denisgav/stm32f401ccu6_uac2_headset/easyeda/Schematic_stm32f401ccu6_uac2_hid_headset_redesign_v2_2024-11-17.pdf

3V3 20 VB 40 C13 39 C14 38 C15 37 Reset 36 A0 35 A1 34 A2 33 A3 32 A4 31 A5 30 A6 29 A7 28 B0 27 B1 26 B2 25 B10 24 3V3 23 GND 22 5V 21 3V3 41 DIO 42 SCK 43 GND 44

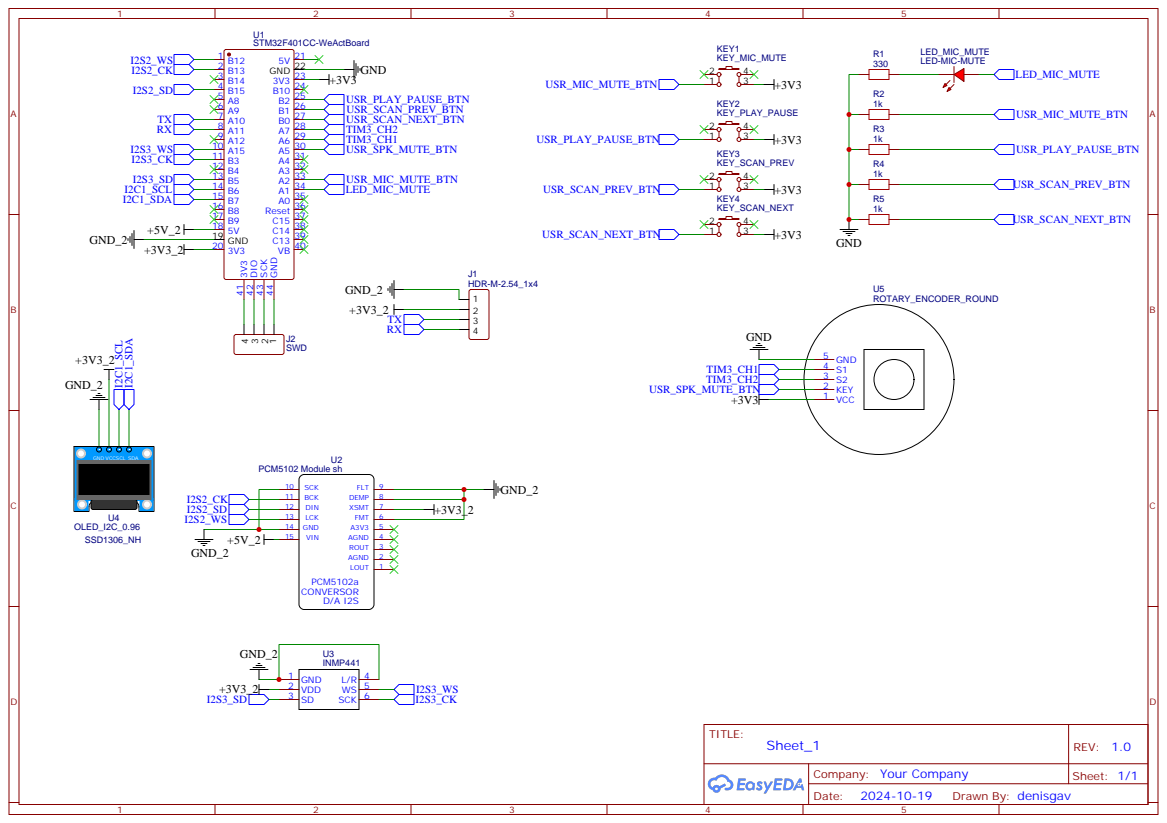
[picture p1: page 1]
