denisgav/stm32f401ccu6_uac2_headset/easyeda/Schematic_ESP32_C3_BT_mouse_drigatel_2024-11-17.pdf

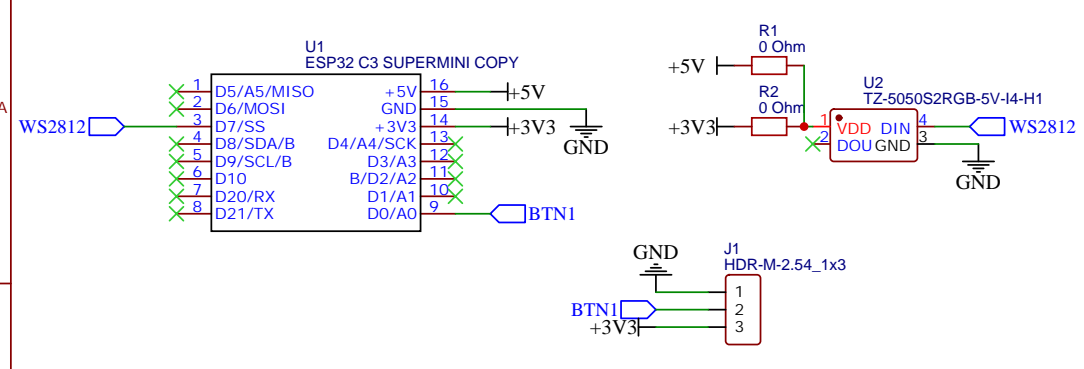
[picture p2: page 1]
