denisgav/stm32f401ccu6_uac2_headset/Core/Src/main.c

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
/* Includes ------------------------------------------------------------------*/
#include "main.h"

/* USER CODE BEGIN Includes */
#include <stdio.h>
#include <string.h>

#include "bsp/board_api.h"
#include "tusb.h"
#include "usb_descriptors.h"

#include "usb_headset.h"
#include "volume_ctrl.h"
#include "ring_buf.h"
#include "usb_headset_settings.h"

#include "ssd1306.h"
#include "ssd1306_fonts.h"

#include "usb_hid_status.h"
/* USER CODE END Includes */

I2C_HandleTypeDef hi2c1;
DMA_HandleTypeDef hdma_i2c1_tx;

I2S_HandleTypeDef hi2s2;
I2S_HandleTypeDef hi2s3;
DMA_HandleTypeDef hdma_spi2_tx;
DMA_HandleTypeDef hdma_spi3_rx;

TIM_HandleTypeDef htim3;

PCD_HandleTypeDef hpcd_USB_OTG_FS;

/* USER CODE BEGIN PV */
usb_headset_settings_t current_settings;

// Buffer for speaker data
ring_buf_t spk_ring_buffer;
uint32_t *spk_ring_buffer_storage;

// Buffer for microphone data
ring_buf_t mic_ring_buffer;
uint32_t *mic_ring_buffer_storage;

// Buffer for speaker data
uint8_t spk_usb_read_buf[SAMPLE_BUFFER_SIZE * 2 * 4 * 2]; // Max size of audio sample is  2 * 4. 2 Channels, 4 byte width sample
i2s_32b_audio_sample spk_32b_i2s_buffer[SAMPLE_BUFFER_SIZE];
i2s_16b_audio_sample spk_16b_i2s_buffer[SAMPLE_BUFFER_SIZE];
uint32_t spk_i2s_buf[SAMPLE_BUFFER_SIZE * 2];

// Buffer for microphone data
uint32_t mic_usb_24b_buffer[SAMPLE_BUFFER_SIZE];
uint16_t mic_usb_16b_buffer[SAMPLE_BUFFER_SIZE];
uint32_t mic_i2s_buf[SAMPLE_BUFFER_SIZE * 2];
uint32_t mic_i2s_read_buffer[SAMPLE_BUFFER_SIZE];
uint32_t num_of_mic_samples;

uint32_t get_num_of_mic_samples();

usb_hid_status_t hid_status;
void check_buttons(void);
void usb_hid_task(void);

void led_blinking_task(void);

HAL_StatusTypeDef refresh_i2s_spk(void);
HAL_StatusTypeDef refresh_i2s_mic(void);
HAL_StatusTypeDef refresh_clk(void);
void refresh_i2s_connections(void);

int32_t usb_to_i2s_32b_sample_convert(int32_t sample, uint32_t volume_db);
int16_t usb_to_i2s_16b_sample_convert(int16_t sample, uint32_t volume_db);

void usb_headset_mute_handler(int8_t bChannelNumber, int8_t mute_in);
void usb_headset_volume_handler(int8_t bChannelNumber, int16_t volume_in);
void usb_headset_current_sample_rate_handler(uint32_t current_sample_rate_in);
void usb_headset_current_resolution_handler(uint8_t itf,
		uint8_t current_resolution_in);
void usb_headset_current_status_set_handler(uint8_t itf,
		uint32_t blink_interval_ms_in);

void usb_headset_tud_audio_rx_done_pre_read_handler(uint8_t rhport,
		uint16_t n_bytes_received, uint8_t func_id, uint8_t ep_out,
		uint8_t cur_alt_setting);
void usb_headset_tud_audio_tx_done_pre_load_handler(uint8_t rhport, uint8_t itf,
		uint8_t ep_in, uint8_t cur_alt_setting);
void usb_headset_tud_audio_tx_done_post_load_handler(uint8_t rhport,
		uint16_t n_bytes_copied, uint8_t itf, uint8_t ep_in,
		uint8_t cur_alt_setting);

int spk_machine_i2s_write_stream(uint32_t *buf_in, uint32_t size);
int mic_machine_i2s_read_stream(uint32_t *buf_in, uint32_t size);

void HAL_I2S_TxHalfCpltCallback(I2S_HandleTypeDef *hi2s);
void HAL_I2S_TxCpltCallback(I2S_HandleTypeDef *hi2s);
void HAL_I2S_RxHalfCpltCallback(I2S_HandleTypeDef *hi2s);
void HAL_I2S_RxCpltCallback(I2S_HandleTypeDef *hi2s);
//void HAL_I2S_ErrorCallback(I2S_HandleTypeDef *hi2s);
void HAL_GPIO_EXTI_Callback(uint16_t GPIO_Pin);

uint32_t feed_spk_dma(uint32_t *dma_buffer_p,
		uint32_t sizeof_half_dma_buffer_in_bytes);

uint32_t empty_mic_dma(uint32_t *dma_buffer_p,
		uint32_t sizeof_half_dma_buffer_in_words);

void status_update_task(void);
void display_ssd1306_info(void);

/* USER CODE END PV */

void SystemClock_Config(void);
void PeriphCommonClock_Config(void);
static void MX_GPIO_Init(void);
static void MX_DMA_Init(void);
static void MX_TIM3_Init(void);
static void MX_I2C1_Init(void);
static void MX_I2S2_Init(void);
static void MX_I2S3_Init(void);
static void MX_USB_OTG_FS_PCD_Init(void);
/**
  * @brief  The application entry point.
  * @retval int
  */
int main(void)
{

  /* MCU Configuration--------------------------------------------------------*/

  /* Reset of all peripherals, Initializes the Flash interface and the Systick. */
  HAL_Init();

  /* Configure the system clock */
  SystemClock_Config();

  /* Configure the peripherals common clocks */
  PeriphCommonClock_Config();

  /* Initialize all configured peripherals */
  MX_GPIO_Init();
  MX_DMA_Init();
  MX_TIM3_Init();
  MX_I2C1_Init();
  MX_I2S2_Init();
  MX_I2S3_Init();
  MX_USB_OTG_FS_PCD_Init();
  /* USER CODE BEGIN 2 */

	current_settings.spk_sample_rate = I2S_SPK_RATE_DEF;
	current_settings.spk_resolution =
	CFG_TUD_AUDIO_FUNC_1_FORMAT_1_RESOLUTION_RX;
	current_settings.spk_blink_interval_ms = BLINK_NOT_MOUNTED;

	current_settings.mic_resolution =
	CFG_TUD_AUDIO_FUNC_1_FORMAT_1_RESOLUTION_RX;
	current_settings.mic_blink_interval_ms = BLINK_NOT_MOUNTED;
	current_settings.usr_mic_mute = false;

	current_settings.status_updated = false;

	usb_headset_set_mute_set_handler(usb_headset_mute_handler);
	usb_headset_set_volume_set_handler(usb_headset_volume_handler);
	usb_headset_set_current_sample_rate_set_handler(
			usb_headset_current_sample_rate_handler);
	usb_headset_set_current_resolution_set_handler(
			usb_headset_current_resolution_handler);
	usb_headset_set_current_status_set_handler(
			usb_headset_current_status_set_handler);

	usb_headset_set_tud_audio_rx_done_pre_read_set_handler(
			usb_headset_tud_audio_rx_done_pre_read_handler);
	usb_headset_set_tud_audio_tx_done_pre_load_set_handler(
			usb_headset_tud_audio_tx_done_pre_load_handler);
	usb_headset_set_tud_audio_tx_done_post_load_set_handler(
			usb_headset_tud_audio_tx_done_post_load_handler);

	for (int i = 0; i < (CFG_TUD_AUDIO_FUNC_1_N_CHANNELS_RX + 1); i++) {
		current_settings.spk_volume[i] = DEFAULT_VOLUME;
		current_settings.spk_mute[i] = 0;
		current_settings.spk_volume_db[i] = vol_to_db_convert_enc(
				current_settings.spk_mute[i], current_settings.spk_volume[i]);
	}

	HAL_GPIO_WritePin(LED_MIC_MUTE_GPIO_Port, LED_MIC_MUTE_Pin, GPIO_PIN_SET);

	usb_headset_init();
	refresh_i2s_connections();

	TU_LOG1("Headset running\r\n");

	// Init SSD
	ssd1306_Init();

	memset(&hid_status, 0x0, sizeof(hid_status));
	HAL_TIM_Encoder_Start_IT(&htim3, TIM_CHANNEL_ALL);

  /* USER CODE END 2 */

  /* Infinite loop */
  /* USER CODE BEGIN WHILE */
	while (1) {
		usb_headset_task(); // TinyUSB device task
		led_blinking_task();
		status_update_task();
		usb_hid_task();

		ssd1306_DMA_task();

    /* USER CODE END WHILE */

    /* USER CODE BEGIN 3 */
	}
  /* USER CODE END 3 */
}

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
/* USER CODE BEGIN 4 */

void refresh_i2s_connections(void) {
	HAL_I2S_StateTypeDef dma_state;
	// Stop speaker DMA
	dma_state = HAL_I2S_GetState(&hi2s2);
	if (dma_state != HAL_I2S_STATE_READY) {
		HAL_StatusTypeDef stop_status = HAL_I2S_DMAStop(&hi2s2);
		if (stop_status != HAL_OK) {
			Error_Handler();
		}
	}

	// Stop microphone DMA
	dma_state = HAL_I2S_GetState(&hi2s3);
	if (dma_state != HAL_I2S_STATE_READY) {
		HAL_StatusTypeDef stop_status = HAL_I2S_DMAStop(&hi2s3);
		if (stop_status != HAL_OK) {
			Error_Handler();
		}
	}

	HAL_StatusTypeDef tx_i2s_status = refresh_i2s_spk();
	if (tx_i2s_status != HAL_OK) {
		Error_Handler();
	}
	HAL_StatusTypeDef rx_i2s_status = refresh_i2s_mic();
	if (rx_i2s_status != HAL_OK) {
		Error_Handler();
	}

	HAL_StatusTypeDef clk_reconfig_status = refresh_clk();
	if (clk_reconfig_status != HAL_OK) {
		Error_Handler();
	}

	if (spk_ring_buffer_storage != NULL) {
		free(spk_ring_buffer_storage);
	}
	if (mic_ring_buffer_storage != NULL) {
		free(mic_ring_buffer_storage);
	}

	current_settings.samples_in_i2s_frame_min =
			(current_settings.spk_sample_rate) / 1000;
	current_settings.samples_in_i2s_frame_max =
			(current_settings.spk_sample_rate + 999) / 1000;

	// Ring buffer contains 2 ms data
	spk_ring_buffer_storage = m_new(uint32_t,
			current_settings.samples_in_i2s_frame_max * 2 * 2);
	ringbuf_init(&spk_ring_buffer, spk_ring_buffer_storage,
			current_settings.samples_in_i2s_frame_max * 2 * 2);

	mic_ring_buffer_storage = m_new(uint32_t,
			current_settings.samples_in_i2s_frame_max * 2 * 2);
	ringbuf_init(&mic_ring_buffer, mic_ring_buffer_storage,
			current_settings.samples_in_i2s_frame_max * 2 * 2);

	// Clear memories
	memset(spk_i2s_buf, 0x0, sizeof(spk_i2s_buf));
	memset(mic_i2s_buf, 0x0, sizeof(mic_i2s_buf));
	memset(mic_usb_24b_buffer, 0x0, sizeof(mic_usb_24b_buffer));
	memset(mic_usb_16b_buffer, 0x0, sizeof(mic_usb_16b_buffer));

	uint16_t num_of_samples_in_buffer =
			current_settings.samples_in_i2s_frame_min * 2;

	// Run transmit DMA
	HAL_StatusTypeDef tx_status = HAL_I2S_Transmit_DMA(&hi2s2, spk_i2s_buf,
			num_of_samples_in_buffer);
	if (tx_status != HAL_OK) {
		Error_Handler();
	}

	HAL_StatusTypeDef rx_status = HAL_I2S_Receive_DMA(&hi2s3, mic_i2s_buf,
			num_of_samples_in_buffer);
	if (rx_status != HAL_OK) {
		Error_Handler();
	}
}

HAL_StatusTypeDef refresh_i2s_spk(void) {
	HAL_StatusTypeDef status = HAL_I2S_DeInit(&hi2s2);
	if (status != HAL_OK)
		return status;

	hi2s2.Instance = SPI2;
	hi2s2.Init.Mode = I2S_MODE_MASTER_TX;
	hi2s2.Init.Standard = I2S_STANDARD_PHILIPS;
	hi2s2.Init.DataFormat =
			(current_settings.spk_resolution == 16) ?
			I2S_DATAFORMAT_16B :
														I2S_DATAFORMAT_32B; //I2S_DATAFORMAT_32B;
	hi2s2.Init.MCLKOutput = I2S_MCLKOUTPUT_DISABLE;
	hi2s2.Init.AudioFreq = current_settings.spk_sample_rate; //I2S_AUDIOFREQ_48K;
	hi2s2.Init.CPOL = I2S_CPOL_LOW;
	hi2s2.Init.ClockSource = I2S_CLOCK_PLL;
	hi2s2.Init.FullDuplexMode = I2S_FULLDUPLEXMODE_DISABLE;
	if (HAL_I2S_Init(&hi2s2) != HAL_OK) {
		Error_Handler();
	}

	return HAL_OK;
}

HAL_StatusTypeDef refresh_i2s_mic(void) {
	HAL_StatusTypeDef status = HAL_I2S_DeInit(&hi2s3);
	if (status != HAL_OK)
		return status;

	hi2s3.Instance = SPI3;
	hi2s3.Init.Mode = I2S_MODE_MASTER_RX;
	hi2s3.Init.Standard = I2S_STANDARD_PHILIPS;
	hi2s3.Init.DataFormat = I2S_DATAFORMAT_32B;
	hi2s3.Init.MCLKOutput = I2S_MCLKOUTPUT_DISABLE;
	hi2s3.Init.AudioFreq = current_settings.spk_sample_rate; //I2S_AUDIOFREQ_48K;
	hi2s3.Init.CPOL = I2S_CPOL_LOW;
	hi2s3.Init.ClockSource = I2S_CLOCK_PLL;
	hi2s3.Init.FullDuplexMode = I2S_FULLDUPLEXMODE_DISABLE;
	if (HAL_I2S_Init(&hi2s3) != HAL_OK) {
		Error_Handler();
	}

	return HAL_OK;
}

HAL_StatusTypeDef refresh_clk(void){
//	typedef struct I2S_CLK_CONFIG_ {
//		uint32_t N;
//		uint32_t R;
//		uint32_t I2SDIV;
//		uint32_t ODD;
//		uint32_t nominal_fdbk;
//	} I2S_CLK_CONFIG;
//	const I2S_CLK_CONFIG I2S_Clk_Config24[3]  = {
//	{429, 4, 19, 0, 0x0B065E56}, // 44.0995
//	{384, 5, 12, 1, 0x0C000000}, // 48.0000
//	{424, 3, 11, 1, 0x1800ED70}  // 96.0144
//	};
//

//	RCC_OscInitTypeDef RCC_OscInitStruct = {0};
	RCC_PeriphCLKInitTypeDef PeriphClkInitStruct = {0};

	if(current_settings.spk_sample_rate == 48000){
//		RCC_OscInitStruct.OscillatorType = RCC_OSCILLATORTYPE_HSE;
//		RCC_OscInitStruct.HSEState = RCC_HSE_ON;
//		RCC_OscInitStruct.PLL.PLLState = RCC_PLL_ON;
//		RCC_OscInitStruct.PLL.PLLSource = RCC_PLLSOURCE_HSE;
//		RCC_OscInitStruct.PLL.PLLM = 25;
//		RCC_OscInitStruct.PLL.PLLN = 336;
//		RCC_OscInitStruct.PLL.PLLP = RCC_PLLP_DIV4;
//		RCC_OscInitStruct.PLL.PLLQ = 7;
//
//		HAL_StatusTypeDef OscConfig_stat = HAL_RCC_OscConfig(&RCC_OscInitStruct);
//		if(OscConfig_stat != HAL_OK){
//			return OscConfig_stat;
//		}

		/** Initializes the peripherals clock
		 */
		PeriphClkInitStruct.PeriphClockSelection = RCC_PERIPHCLK_I2S;
		PeriphClkInitStruct.PLLI2S.PLLI2SN = 384;
		PeriphClkInitStruct.PLLI2S.PLLI2SR = 5;
		HAL_StatusTypeDef PeriphCLKConfig_stat = HAL_RCCEx_PeriphCLKConfig(&PeriphClkInitStruct);
		if(PeriphCLKConfig_stat != HAL_OK){
			Error_Handler();
		}

		return HAL_OK;
	}

	if(current_settings.spk_sample_rate == 44100){
//		RCC_OscInitStruct.OscillatorType = RCC_OSCILLATORTYPE_HSE;
//		RCC_OscInitStruct.HSEState = RCC_HSE_ON;
//		RCC_OscInitStruct.PLL.PLLState = RCC_PLL_ON;
//		RCC_OscInitStruct.PLL.PLLSource = RCC_PLLSOURCE_HSE;
//		RCC_OscInitStruct.PLL.PLLM = 25;
//		RCC_OscInitStruct.PLL.PLLN = 336;
//		RCC_OscInitStruct.PLL.PLLP = RCC_PLLP_DIV4;
//		RCC_OscInitStruct.PLL.PLLQ = 7;
//
//		HAL_StatusTypeDef OscConfig_stat = HAL_RCC_OscConfig(&RCC_OscInitStruct);
//		if(OscConfig_stat != HAL_OK){
//			return OscConfig_stat;
//		}

		/** Initializes the peripherals clock
		 */
		PeriphClkInitStruct.PeriphClockSelection = RCC_PERIPHCLK_I2S;
		PeriphClkInitStruct.PLLI2S.PLLI2SN = 429;
		PeriphClkInitStruct.PLLI2S.PLLI2SR = 4;
		HAL_StatusTypeDef PeriphCLKConfig_stat = HAL_RCCEx_PeriphCLKConfig(&PeriphClkInitStruct);
		if(PeriphCLKConfig_stat != HAL_OK){
			return PeriphCLKConfig_stat;
		}

		return HAL_OK;
	}

	return HAL_ERROR;
}

void usb_headset_mute_handler(int8_t bChannelNumber, int8_t mute_in) {
	current_settings.spk_mute[bChannelNumber] = mute_in;
	current_settings.spk_volume_db[bChannelNumber] = vol_to_db_convert_enc(
			current_settings.spk_mute[bChannelNumber],
			current_settings.spk_volume[bChannelNumber]);

	current_settings.spk_volume_mul_db[0] = current_settings.spk_volume_db[0]
			* current_settings.spk_volume_db[1]; // Left ch volume
	current_settings.spk_volume_mul_db[1] = current_settings.spk_volume_db[0]
			* current_settings.spk_volume_db[2]; // Right ch volume

	current_settings.status_updated = true;
}

void usb_headset_volume_handler(int8_t bChannelNumber, int16_t volume_in) {
	current_settings.spk_volume[bChannelNumber] = volume_in;
	current_settings.spk_volume_db[bChannelNumber] = vol_to_db_convert_enc(
			current_settings.spk_mute[bChannelNumber],
			current_settings.spk_volume[bChannelNumber]);

	current_settings.spk_volume_mul_db[0] = current_settings.spk_volume_db[0]
			* current_settings.spk_volume_db[1]; // Left ch volume
	current_settings.spk_volume_mul_db[1] = current_settings.spk_volume_db[0]
			* current_settings.spk_volume_db[2]; // Right ch volume

	current_settings.status_updated = true;
}

void usb_headset_current_sample_rate_handler(uint32_t current_sample_rate_in) {
	current_settings.spk_sample_rate = current_sample_rate_in;
	refresh_i2s_connections();
	current_settings.status_updated = true;
}

void usb_headset_current_resolution_handler(uint8_t itf,
		uint8_t current_resolution_in) {
	if ((itf == 0) || (itf == ITF_NUM_AUDIO_STREAMING_SPK))
		current_settings.spk_resolution = current_resolution_in;
	if ((itf == 0) || (itf == ITF_NUM_AUDIO_STREAMING_MIC))
		current_settings.mic_resolution = current_resolution_in;

	refresh_i2s_connections();
	current_settings.status_updated = true;
}

void usb_headset_current_status_set_handler(uint8_t itf,
		uint32_t blink_interval_ms_in) {
	if ((itf == 0) || (itf == ITF_NUM_AUDIO_STREAMING_SPK))
		current_settings.spk_blink_interval_ms = blink_interval_ms_in;
	if ((itf == 0) || (itf == ITF_NUM_AUDIO_STREAMING_MIC))
		current_settings.mic_blink_interval_ms = blink_interval_ms_in;
	current_settings.status_updated = true;
}

void usb_headset_tud_audio_rx_done_pre_read_handler(uint8_t rhport,
		uint16_t n_bytes_received, uint8_t func_id, uint8_t ep_out,
		uint8_t cur_alt_setting) {
	uint32_t volume_db_left = current_settings.spk_volume_mul_db[0];
	uint32_t volume_db_right = current_settings.spk_volume_mul_db[1];

	if (current_settings.spk_blink_interval_ms == BLINK_STREAMING) {
		// Speaker data size received in the last frame
		uint16_t usb_spk_data_size = tud_audio_n_read(func_id, spk_usb_read_buf,
				n_bytes_received);
		//uint16_t usb_spk_data_size = tud_audio_read(spk_usb_read_buf,
		//		n_bytes_received);
		uint16_t usb_sample_count = 0;

		if (current_settings.spk_resolution == 16) {
			int16_t *in = (int16_t*) spk_usb_read_buf;
			usb_sample_count = usb_spk_data_size / 4; // 4 bytes per sample 2b left, 2b right

			//if (usb_sample_count >= current_settings.samples_in_i2s_frame_min) {
			for (int i = 0; i < usb_sample_count; i++) {
				int16_t left = in[i * 2 + 0];
				int16_t right = in[i * 2 + 1];

				left = usb_to_i2s_16b_sample_convert(left, volume_db_left);
				right = usb_to_i2s_16b_sample_convert(right, volume_db_right);

				spk_16b_i2s_buffer[i].left = left;
				spk_16b_i2s_buffer[i].right = right;
			}
			spk_machine_i2s_write_stream(&spk_16b_i2s_buffer[0],
					usb_sample_count); // Number of words
			//}
		} else if (current_settings.spk_resolution == 24) {
			int32_t *in = (int32_t*) spk_usb_read_buf;
			usb_sample_count = usb_spk_data_size / 8; // 8 bytes per sample 4b left, 4b right

			//if (usb_sample_count >= current_settings.samples_in_i2s_frame_min) {
			for (int i = 0; i < usb_sample_count; i++) {
				int32_t left = in[i * 2 + 0];
				int32_t right = in[i * 2 + 1];

				left = usb_to_i2s_32b_sample_convert(left, volume_db_left);
				right = usb_to_i2s_32b_sample_convert(right, volume_db_right);

				spk_32b_i2s_buffer[i].left = left;
				spk_32b_i2s_buffer[i].right = right;
			}
			spk_machine_i2s_write_stream(&spk_32b_i2s_buffer[0],
					usb_sample_count * 2); // Number of words
			//}
		}
	}
}

uint32_t get_num_of_mic_samples(){
	static uint32_t format_44100_khz_counter = 0;
	if(current_settings.spk_sample_rate == 44100){
		format_44100_khz_counter++;
		if(format_44100_khz_counter >= 9){
			format_44100_khz_counter = 0;
			return 45;
		} else {
			return 44;
		}
	} else {
		return current_settings.samples_in_i2s_frame_min;
	}
}

void usb_headset_tud_audio_tx_done_pre_load_handler(uint8_t rhport, uint8_t itf,
		uint8_t ep_in, uint8_t cur_alt_setting) {
	if (current_settings.mic_blink_interval_ms == BLINK_STREAMING) {
		if (current_settings.mic_resolution == 24) {
			uint32_t buffer_size = num_of_mic_samples
					* CFG_TUD_AUDIO_FUNC_1_FORMAT_2_N_BYTES_PER_SAMPLE_TX
					* CFG_TUD_AUDIO_FUNC_1_N_CHANNELS_TX;
			uint16_t bytes_writen = tud_audio_write(&(mic_usb_24b_buffer[0]),
					buffer_size);
		} else {
			uint32_t buffer_size = num_of_mic_samples
					* CFG_TUD_AUDIO_FUNC_1_FORMAT_1_N_BYTES_PER_SAMPLE_TX
					* CFG_TUD_AUDIO_FUNC_1_N_CHANNELS_TX;
			uint16_t bytes_writen = tud_audio_write(&(mic_usb_16b_buffer[0]),
					buffer_size);
		}
	}
}

void usb_headset_tud_audio_tx_done_post_load_handler(uint8_t rhport,
		uint16_t n_bytes_copied, uint8_t itf, uint8_t ep_in,
		uint8_t cur_alt_setting) {

	if (current_settings.mic_blink_interval_ms != BLINK_STREAMING) {
		return;
	}

	if (current_settings.usr_mic_mute == true) {
		if (current_settings.mic_resolution == 24) {
			memset(mic_usb_24b_buffer, 0x0, sizeof(mic_usb_24b_buffer));
		} else {
			memset(mic_usb_16b_buffer, 0x0, sizeof(mic_usb_16b_buffer));
		}
		return;
	}

	// Read data from microphone
	num_of_mic_samples = get_num_of_mic_samples();
	uint32_t buffer_size_read = num_of_mic_samples;
	int num_words_read = mic_machine_i2s_read_stream(&mic_i2s_read_buffer[0],
			buffer_size_read);
	int num_of_frames_read = num_words_read;

	if (num_of_frames_read >= current_settings.samples_in_i2s_frame_min) {
		for (uint32_t i = 0; i < num_of_frames_read; i++) {
			if (current_settings.mic_resolution == 24) {
				int32_t mono_24b = (int32_t) mic_i2s_read_buffer[i]
						<< MIC_FORMAT_24B_TO_24B_SHIFT_VAL; // Magic number

				mic_usb_24b_buffer[i] = mono_24b; // TODO: check this value
			} else {
				int32_t mono_24b = (int32_t) mic_i2s_read_buffer[i]
						>> MIC_FORMAT_24B_TO_16B_SHIFT_VAL; // Magic number

				mic_usb_16b_buffer[i] = mono_24b; // TODO: check this value
			}
		}
	} else {
		if (current_settings.mic_resolution == 24) {
			memset(mic_usb_24b_buffer, 0x0, sizeof(mic_usb_24b_buffer));
		} else {
			memset(mic_usb_16b_buffer, 0x0, sizeof(mic_usb_16b_buffer));
		}
	}
}

int32_t usb_to_i2s_32b_sample_convert(int32_t sample, uint32_t volume_db) {
	int64_t sample_tmp = (int64_t) sample * (int64_t) volume_db;
	sample_tmp = sample_tmp >> 30;
	return (int32_t) sample_tmp;
//	return (int32_t)sample;
}

int16_t usb_to_i2s_16b_sample_convert(int16_t sample, uint32_t volume_db) {
	int64_t sample_tmp = (int64_t) sample * (int64_t) volume_db;
	sample_tmp = sample_tmp >> 30;
	return (int16_t) sample_tmp;
//	return (int16_t)sample;
}

//--------------------------------------------------------------------+
// BLINKING TASK
//--------------------------------------------------------------------+
void led_blinking_task(void) {
	static uint32_t start_ms = 0;
	static bool led_state = false;

	uint32_t cur_time_ms = board_millis();

	// Blink every interval ms
	if (cur_time_ms - start_ms < current_settings.spk_blink_interval_ms)
		return;
	start_ms += current_settings.spk_blink_interval_ms;

	board_led_write(led_state);
	led_state = 1 - led_state;
}

int spk_machine_i2s_write_stream(uint32_t *buf_in, uint32_t size) {
	if (size == 0) {
		return 0;
	}

	// copy audio samples from the app buffer to the ring buffer
	// loop, reading samples until the app buffer is emptied
	// for uasyncio mode, the loop will make an early exit if the ring buffer becomes full

	// Not allow buffer overflow
	uint16_t available_space = ringbuf_available_space(&spk_ring_buffer);
	if(available_space <= size){
		return 0;
	}

	if (current_settings.spk_resolution == 24) {
		for (uint32_t a_index = 0; a_index < size; a_index++) {
			if (ringbuf_push_half_word_swap(&spk_ring_buffer,
					buf_in[a_index]) == false) {
				return a_index;
			}
		}
	} else {
		for (uint32_t a_index = 0; a_index < size; a_index++) {
			if (ringbuf_push(&spk_ring_buffer, buf_in[a_index]) == false) {
				return a_index;
			}
		}
	}

	return size;
}

int mic_machine_i2s_read_stream(uint32_t *buf_in, uint32_t size) {
	if (size == 0) {
		return 0;
	}

	uint32_t available_data_words = ringbuf_available_data(&mic_ring_buffer);

	if (available_data_words >= size) {
		for (uint32_t i = 0; i < size; i++) {
			if (ringbuf_pop_half_word_swap(&mic_ring_buffer,
					&buf_in[i]) == false) {
				return i;
			}
		}
		return size;
	} else {
		// underflow.  clear buffer to transmit "silence" on the I2S bus
		memset(buf_in, 0, size * sizeof(uint32_t));
		return size;
	}
}

void HAL_I2S_TxHalfCpltCallback(I2S_HandleTypeDef *hi2s) {
	int num_of_words_feed =
			(current_settings.spk_resolution == 24) ?
					current_settings.samples_in_i2s_frame_min :
					current_settings.samples_in_i2s_frame_min / 2;
	feed_spk_dma(&spk_i2s_buf[0], num_of_words_feed);
}

void HAL_I2S_TxCpltCallback(I2S_HandleTypeDef *hi2s) {
	int num_of_words_feed =
			(current_settings.spk_resolution == 24) ?
					current_settings.samples_in_i2s_frame_min :
					current_settings.samples_in_i2s_frame_min / 2;
	feed_spk_dma(&spk_i2s_buf[num_of_words_feed], num_of_words_feed);
}

void HAL_I2S_RxHalfCpltCallback(I2S_HandleTypeDef *hi2s) {
	int num_of_words_empty = current_settings.samples_in_i2s_frame_min;
	empty_mic_dma(&mic_i2s_buf[0], num_of_words_empty);
}

void HAL_I2S_RxCpltCallback(I2S_HandleTypeDef *hi2s) {
	int num_of_words_empty = current_settings.samples_in_i2s_frame_min;
	empty_mic_dma(&mic_i2s_buf[num_of_words_empty],
			num_of_words_empty);
}

/**
 * @brief  EXTI line detection callbacks.
 * @param  GPIO_Pin Specifies the pins connected EXTI line
 * @retval None
 */
void HAL_GPIO_EXTI_Callback(uint16_t GPIO_Pin) {
	// No interrupts are connected...
	// Nothing to do here

//	static uint32_t prev_btb_press__ms = 0;
//
//	uint32_t cur_time_ms = board_millis();
//
//	if (cur_time_ms - prev_btb_press__ms < 50)
//		return;
//
//	prev_btb_press__ms = cur_time_ms;
}

void HAL_I2S_ErrorCallback(I2S_HandleTypeDef *hi2s) {
	refresh_i2s_connections();
}

uint32_t feed_spk_dma(uint32_t *dma_buffer_p,
		uint32_t sizeof_half_dma_buffer_in_words) {
	// when data exists, copy samples from ring buffer
	uint32_t available_data_words = ringbuf_available_data(&spk_ring_buffer);
	if (available_data_words > sizeof_half_dma_buffer_in_words) {
		available_data_words = sizeof_half_dma_buffer_in_words;
	}

	if (available_data_words >= sizeof_half_dma_buffer_in_words) {
		for (uint32_t i = 0; i < sizeof_half_dma_buffer_in_words; i++) {
			ringbuf_pop(&spk_ring_buffer, &dma_buffer_p[i]);
		}
		return available_data_words;
	} else {
		// underflow.  clear buffer to transmit "silence" on the I2S bus
		memset(dma_buffer_p, 0,
				sizeof_half_dma_buffer_in_words * sizeof(uint32_t));
		return sizeof_half_dma_buffer_in_words;
	}
}

uint32_t empty_mic_dma(uint32_t *dma_buffer_p,
		uint32_t sizeof_half_dma_buffer_in_words) {
	// when space exists, copy samples into ring buffer
	if (ringbuf_available_space(&mic_ring_buffer)
			>= sizeof_half_dma_buffer_in_words) {
		for (uint32_t i = 0; i < sizeof_half_dma_buffer_in_words; i += 2) {
			if (ringbuf_push(&mic_ring_buffer, dma_buffer_p[i]) == false)
				return i;
		}
	}
	return sizeof_half_dma_buffer_in_words;
}

//--------------------------------------------------------------------+
// STATUS UPDATE TASK
//--------------------------------------------------------------------+
void status_update_task(void) {
	static uint32_t prev_status_update__ms = 0;

	uint32_t cur_time_ms = board_millis();

	HAL_GPIO_WritePin(LED_MIC_MUTE_GPIO_Port, LED_MIC_MUTE_Pin,
			current_settings.usr_mic_mute ? GPIO_PIN_SET : GPIO_PIN_RESET);

	// Update status once per second
	if (cur_time_ms - prev_status_update__ms < 100)
		return;

	prev_status_update__ms = cur_time_ms;

	if (current_settings.status_updated == true) {
		current_settings.status_updated = false;
		display_ssd1306_info();
	}
}

void display_ssd1306_info(void) {
	char fmt_tmp_str[20] = "";

	ssd1306_Fill(Black);

	switch (current_settings.spk_blink_interval_ms) {
	case BLINK_NOT_MOUNTED: {
		ssd1306_SetCursor(4, 0);
		ssd1306_WriteString("Spk not mounted", Font_6x8, White);
		break;
	}
	case BLINK_SUSPENDED: {
		ssd1306_SetCursor(4, 0);
		ssd1306_WriteString("Spk suspended", Font_6x8, White);
		break;
	}
	case BLINK_MOUNTED: {
		ssd1306_SetCursor(4, 0);
		ssd1306_WriteString("Spk mounted", Font_6x8, White);
		break;
	}
	case BLINK_STREAMING: {
		char spk_streaming_str[20] = "Spk stream: ";
		memset(fmt_tmp_str, 0x0, sizeof(fmt_tmp_str));

		itoa(current_settings.spk_resolution, fmt_tmp_str, 10);
		strcat(spk_streaming_str, fmt_tmp_str);
		strcat(spk_streaming_str, " bit");

		ssd1306_SetCursor(4, 0);
		ssd1306_WriteString(spk_streaming_str, Font_6x8, White);
		break;
	}
	default: {
		ssd1306_SetCursor(4, 0);
		ssd1306_WriteString("Spk unknown", Font_6x8, White);
		break;
	}
	}

	switch (current_settings.mic_blink_interval_ms) {
	case BLINK_NOT_MOUNTED: {
		ssd1306_SetCursor(4, 8);
		ssd1306_WriteString("Mic not mounted", Font_6x8, White);
		break;
	}
	case BLINK_SUSPENDED: {
		ssd1306_SetCursor(4, 8);
		ssd1306_WriteString("Mic suspended", Font_6x8, White);
		break;
	}
	case BLINK_MOUNTED: {
		ssd1306_SetCursor(4, 8);
		ssd1306_WriteString("Mic mounted", Font_6x8, White);
		break;
	}
	case BLINK_STREAMING: {
		char mic_streaming_str[20] = "Mic stream: ";
		memset(fmt_tmp_str, 0x0, sizeof(fmt_tmp_str));

		itoa(current_settings.mic_resolution, fmt_tmp_str, 10);
		strcat(mic_streaming_str, fmt_tmp_str);
		strcat(mic_streaming_str, " bit");

		ssd1306_SetCursor(4, 8);
		ssd1306_WriteString(mic_streaming_str, Font_6x8, White);
		break;
	}
	default: {
		ssd1306_SetCursor(4, 8);
		ssd1306_WriteString("Mic unknown", Font_6x8, White);
		break;
	}
	}

	{
		char freq_str[20] = "Freq: ";

		memset(fmt_tmp_str, 0x0, sizeof(fmt_tmp_str));

		itoa((current_settings.spk_sample_rate), fmt_tmp_str, 10);
		strcat(freq_str, fmt_tmp_str);
		strcat(freq_str, " Hz");

		ssd1306_SetCursor(4, 16);
		ssd1306_WriteString(freq_str, Font_6x8, White);

	}

	{
		char vol_m_str[20] = "Vol M:";
		char vol_l_str[20] = "Vol L:";
		char vol_r_str[20] = "Vol R:";

		memset(fmt_tmp_str, 0x0, sizeof(fmt_tmp_str));
		itoa((current_settings.spk_volume[0] >> ENC_NUM_OF_FP_BITS),
				fmt_tmp_str, 10);
		strcat(vol_m_str, fmt_tmp_str);

		memset(fmt_tmp_str, 0x0, sizeof(fmt_tmp_str));
		itoa((current_settings.spk_volume[1] >> ENC_NUM_OF_FP_BITS),
				fmt_tmp_str, 10);
		strcat(vol_l_str, fmt_tmp_str);

		memset(fmt_tmp_str, 0x0, sizeof(fmt_tmp_str));
		itoa((current_settings.spk_volume[2] >> ENC_NUM_OF_FP_BITS),
				fmt_tmp_str, 10);
		strcat(vol_r_str, fmt_tmp_str);

		ssd1306_SetCursor(4, 24);
		ssd1306_WriteString(vol_m_str, Font_6x8, White);
		ssd1306_SetCursor(4, 32);
		ssd1306_WriteString(vol_l_str, Font_6x8, White);
		ssd1306_SetCursor(4, 40);
		ssd1306_WriteString(vol_r_str, Font_6x8, White);

		char mute_m_str[20] = "Mute M:";
		char mute_l_str[20] = "Mute L:";
		char mute_r_str[20] = "Mute R:";

		strcat(mute_m_str, (current_settings.spk_mute[0] ? "T" : "F"));
		strcat(mute_l_str, (current_settings.spk_mute[1] ? "T" : "F"));
		strcat(mute_r_str, (current_settings.spk_mute[2] ? "T" : "F"));

		ssd1306_SetCursor(68, 24);
		ssd1306_WriteString(mute_m_str, Font_6x8, White);
		ssd1306_SetCursor(68, 32);
		ssd1306_WriteString(mute_l_str, Font_6x8, White);
		ssd1306_SetCursor(68, 40);
		ssd1306_WriteString(mute_r_str, Font_6x8, White);

		char hid_stat_str[20] = "HID susp: ";
		strcat(hid_stat_str, (tud_suspended() ? "T" : "F"));
		strcat(hid_stat_str, ", rdy: ");
		strcat(hid_stat_str, (tud_hid_ready() ? "T" : "F"));

		ssd1306_SetCursor(4, 48);
		ssd1306_WriteString(hid_stat_str, Font_6x8, White);

	}
	ssd1306_UpdateScreen_DMA();
}

//-----------------------------------------------------------------
//                 USB HID
//-----------------------------------------------------------------

// Invoked when received GET_REPORT control request
// Application must fill buffer report's content and return its length.
// Return zero will cause the stack to STALL request
uint16_t tud_hid_get_report_cb(uint8_t instance, uint8_t report_id,
		hid_report_type_t report_type, uint8_t *buffer, uint16_t reqlen) {
	// TODO not Implemented
	(void) instance;
	(void) report_id;
	(void) report_type;
	(void) buffer;
	(void) reqlen;

	return 0;
}

// Invoked when received SET_REPORT control request or
// received data on OUT endpoint ( Report ID = 0, Type = 0 )
void tud_hid_set_report_cb(uint8_t instance, uint8_t report_id,
		hid_report_type_t report_type, uint8_t const *buffer, uint16_t bufsize) {
	(void) instance;

//  if (report_type == HID_REPORT_TYPE_OUTPUT)
//  {
//    // Set keyboard LED e.g Capslock, Numlock etc...
//    if (report_id == REPORT_ID_KEYBOARD)
//    {
//      // bufsize should be (at least) 1
//      if ( bufsize < 1 ) return;
//
//      uint8_t const kbd_leds = buffer[0];
//
//      if (kbd_leds & KEYBOARD_LED_CAPSLOCK)
//      {
//        // Capslock On: disable blink, turn led on
//        blink_interval_ms = 0;
//        board_led_write(true);
//      }else
//      {
//        // Caplocks Off: back to normal blink
//        board_led_write(false);
//        blink_interval_ms = BLINK_MOUNTED;
//      }
//    }
//  }
}

void check_buttons(void) {
	//--------------
	// Checking play/pause, scan prev/next buttons
	//--------------
	GPIO_PinState play_pause_pin_state = HAL_GPIO_ReadPin(
	USR_PLAY_PAUSE_BTN_GPIO_Port, USR_PLAY_PAUSE_BTN_Pin);
	GPIO_PinState scan_prev_pin_state = HAL_GPIO_ReadPin(
	USR_SCAN_PREV_BTN_GPIO_Port, USR_SCAN_PREV_BTN_Pin);
	GPIO_PinState scan_next_pin_state = HAL_GPIO_ReadPin(
	USR_SCAN_NEXT_BTN_GPIO_Port, USR_SCAN_NEXT_BTN_Pin);

	if ((play_pause_pin_state == GPIO_PIN_SET)
			&& (hid_status.btn_play_pause_status == GPIO_PIN_RESET)) {
		hid_status.custom_ctrl_scan_code_updated = true;
		hid_status.cur_custom_ctrl_scan_code =
		MY_TUD_HID_CONSUMER_PLAY_PAUSE_CODE;
	}
	hid_status.btn_play_pause_status = play_pause_pin_state;

	if ((scan_prev_pin_state == GPIO_PIN_SET)
			&& (hid_status.btn_scan_prev_status == GPIO_PIN_RESET)) {
		hid_status.custom_ctrl_scan_code_updated = true;
		hid_status.cur_custom_ctrl_scan_code =
		MY_TUD_HID_CONSUMER_SCAN_PREVIOUS_CODE;
	}
	hid_status.btn_scan_next_status = scan_prev_pin_state;

	if ((scan_next_pin_state == GPIO_PIN_SET)
			&& (hid_status.btn_scan_next_status == GPIO_PIN_RESET)) {
		hid_status.custom_ctrl_scan_code_updated = true;
		hid_status.cur_custom_ctrl_scan_code =
		MY_TUD_HID_CONSUMER_SCAN_NEXT_CODE;
	}
	hid_status.btn_scan_next_status = scan_next_pin_state;
	//--------------

	//--------------
	// Checking MIC mute button
	//--------------
	GPIO_PinState mic_mute_pin_state = HAL_GPIO_ReadPin(
	USR_MIC_MUTE_BTN_GPIO_Port, USR_MIC_MUTE_BTN_Pin);
	if ((mic_mute_pin_state == GPIO_PIN_SET)
			&& (hid_status.btn_mic_mute_status == GPIO_PIN_RESET)) {
		current_settings.usr_mic_mute = !current_settings.usr_mic_mute;
	}
	hid_status.btn_mic_mute_status = mic_mute_pin_state;

	//--------------
	// Checking SPK mute button
	//--------------
	GPIO_PinState spk_mute_pin_state = HAL_GPIO_ReadPin(
	USR_SPK_MUTE_BTN_GPIO_Port, USR_SPK_MUTE_BTN_Pin);
	if ((spk_mute_pin_state == GPIO_PIN_RESET)
			&& (hid_status.btn_spk_mute_status == GPIO_PIN_SET)) {
		hid_status.cur_custom_ctrl_scan_code = MY_TUD_HID_CONSUMER_MUTE_CODE;
		hid_status.custom_ctrl_scan_code_updated = true;
	}
	hid_status.btn_spk_mute_status = spk_mute_pin_state;
}

void usb_hid_task(void) {
	static uint32_t prev_hid_tasc_call__ms = 0;
	static bool prev_media_report_is_not_empty = false;

	uint32_t cur_time_ms = board_millis();

	// Update status once per second
	if (cur_time_ms - prev_hid_tasc_call__ms < 50)
		return;

	//--------------
	// Checking rotary encoder
	//--------------
	int16_t volume_rotary_encoder_cntr = __HAL_TIM_GET_COUNTER(&htim3);
	if (volume_rotary_encoder_cntr
			!= hid_status.volume_rotary_encoder_cntr_prev) {
		hid_status.cur_custom_ctrl_scan_code =
				(volume_rotary_encoder_cntr
						> hid_status.volume_rotary_encoder_cntr_prev) ?
						MY_TUD_HID_CONSUMER_VOLUME_INCREMENT_CODE :
						MY_TUD_HID_CONSUMER_VOLUME_DECREMENT_CODE;

		hid_status.custom_ctrl_scan_code_updated = true;

		hid_status.volume_rotary_encoder_cntr_prev = volume_rotary_encoder_cntr;
	}
	//--------------

	//--------------
	// Checking buttons
	//--------------
	check_buttons();
	//--------------

	// Remote wakeup
	if (tud_suspended() && (hid_status.cur_custom_ctrl_scan_code != 0x0)
			&& (hid_status.custom_ctrl_scan_code_updated == true)) {
		// Wake up host if we are in suspend mode
		// and REMOTE_WAKEUP feature is enabled by host
		tud_remote_wakeup();
	} else {
		if (!tud_hid_ready())
			return;

		if (hid_status.custom_ctrl_scan_code_updated == true) {
			tud_hid_report(REPORT_ID_CONSUMER_CONTROL,
					&(hid_status.cur_custom_ctrl_scan_code),
					sizeof(hid_status.cur_custom_ctrl_scan_code));

			hid_status.cur_custom_ctrl_scan_code = 0x0;
			hid_status.custom_ctrl_scan_code_updated = false;
			prev_media_report_is_not_empty = true;
		} else {
			if (prev_media_report_is_not_empty) {
				uint8_t empty_scan_code = 0x0;
				tud_hid_report(REPORT_ID_CONSUMER_CONTROL, &(empty_scan_code),
						sizeof(empty_scan_code));
				prev_media_report_is_not_empty = false;
			}
		}
	}
}

//-----------------------------------------------------------------
//-----------------------------------------------------------------

/* USER CODE END 4 */
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
