denisgav/stm32f401ccu6_uac2_headset/Core/Inc/main.h

#define ONBOARD_LED_Pin GPIO_PIN_13
#define ONBOARD_LED_GPIO_Port GPIOC
#define LED_MIC_MUTE_Pin GPIO_PIN_1
#define LED_MIC_MUTE_GPIO_Port GPIOA
#define USR_MIC_MUTE_BTN_Pin GPIO_PIN_2
#define USR_MIC_MUTE_BTN_GPIO_Port GPIOA
#define USR_SPK_MUTE_BTN_Pin GPIO_PIN_5
#define USR_SPK_MUTE_BTN_GPIO_Port GPIOA
#define USR_SCAN_NEXT_BTN_Pin GPIO_PIN_0
#define USR_SCAN_NEXT_BTN_GPIO_Port GPIOB
#define USR_SCAN_PREV_BTN_Pin GPIO_PIN_1
#define USR_SCAN_PREV_BTN_GPIO_Port GPIOB
#define USR_PLAY_PAUSE_BTN_Pin GPIO_PIN_2
#define USR_PLAY_PAUSE_BTN_GPIO_Port GPIOB
#define MIC_FORMAT_24B_TO_24B_SHIFT_VAL 4u
#define MIC_FORMAT_24B_TO_16B_SHIFT_VAL 12u
#define SAMPLE_BUFFER_SIZE  (CFG_TUD_AUDIO_FUNC_1_MAX_SAMPLE_RATE/1000) // MAX sample rate divided by 1000. Size of 1 ms sample
