denisgav/stm32f401ccu6_uac2_headset/tinyusb/hw/bsp/stm32f4/family.c

/*
 * The MIT License (MIT)
 *
 * Copyright (c) 2019 Ha Thach (tinyusb.org)
 *
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
 * This file is part of the TinyUSB stack.
 */

#include "stm32f4xx_hal.h"
#include "bsp/board_api.h"
#include "board.h"

//--------------------------------------------------------------------+
// Forward USB interrupt events to TinyUSB IRQ Handler
//--------------------------------------------------------------------+
void OTG_FS_IRQHandler(void) {
  tud_int_handler(0);
}

void OTG_HS_IRQHandler(void) {
  tud_int_handler(1);
}

//--------------------------------------------------------------------+
// MACRO TYPEDEF CONSTANT ENUM
//--------------------------------------------------------------------+
#ifdef UART_DEV
UART_HandleTypeDef UartHandle;
#endif

void board_init(void) {
  //board_clock_init();
  //SystemCoreClockUpdate();

#if CFG_TUSB_OS == OPT_OS_NONE
  // 1ms tick timer
  SysTick_Config(SystemCoreClock / 1000);
#elif CFG_TUSB_OS == OPT_OS_FREERTOS
  // Explicitly disable systick to prevent its ISR runs before scheduler start
  SysTick->CTRL &= ~1U;

  // If freeRTOS is used, IRQ priority is limit by max syscall ( smaller is higher )
  NVIC_SetPriority(OTG_FS_IRQn, configLIBRARY_MAX_SYSCALL_INTERRUPT_PRIORITY );
#endif

  GPIO_InitTypeDef GPIO_InitStruct;

  // LED
  GPIO_InitStruct.Pin = LED_PIN;
  GPIO_InitStruct.Mode = GPIO_MODE_OUTPUT_PP;
  GPIO_InitStruct.Pull = GPIO_PULLUP;
  GPIO_InitStruct.Speed = GPIO_SPEED_FREQ_HIGH;
  HAL_GPIO_Init(LED_PORT, &GPIO_InitStruct);

  board_led_write(false);

  // Button
  GPIO_InitStruct.Pin = BUTTON_PIN;
  GPIO_InitStruct.Mode = GPIO_MODE_INPUT;
  GPIO_InitStruct.Pull = BUTTON_STATE_ACTIVE ? GPIO_PULLDOWN : GPIO_PULLUP;
  GPIO_InitStruct.Speed = GPIO_SPEED_FREQ_HIGH;
  HAL_GPIO_Init(BUTTON_PORT, &GPIO_InitStruct);

#ifdef UART_DEV
  // UART
  GPIO_InitStruct.Pin = UART_TX_PIN | UART_RX_PIN;
  GPIO_InitStruct.Mode = GPIO_MODE_AF_PP;
  GPIO_InitStruct.Pull = GPIO_PULLUP;
  GPIO_InitStruct.Speed = GPIO_SPEED_FREQ_HIGH;
  GPIO_InitStruct.Alternate = UART_GPIO_AF;
  HAL_GPIO_Init(UART_GPIO_PORT, &GPIO_InitStruct);

  UartHandle = (UART_HandleTypeDef) {
      .Instance        = UART_DEV,
      .Init.BaudRate   = CFG_BOARD_UART_BAUDRATE,
      .Init.WordLength = UART_WORDLENGTH_8B,
      .Init.StopBits   = UART_STOPBITS_1,
      .Init.Parity     = UART_PARITY_NONE,
      .Init.HwFlowCtl  = UART_HWCONTROL_NONE,
      .Init.Mode       = UART_MODE_TX_RX,
      .Init.OverSampling = UART_OVERSAMPLING_16
  };
  HAL_UART_Init(&UartHandle);
#endif

#if BOARD_TUD_RHPORT == 0
  /* Configure USB FS GPIOs */
  __HAL_RCC_GPIOA_CLK_ENABLE();

  /* Configure USB D+ D- Pins */
  GPIO_InitStruct.Pin = GPIO_PIN_11 | GPIO_PIN_12;
  GPIO_InitStruct.Speed = GPIO_SPEED_HIGH;
  GPIO_InitStruct.Mode = GPIO_MODE_AF_PP;
  GPIO_InitStruct.Pull = GPIO_NOPULL;
  GPIO_InitStruct.Alternate = GPIO_AF10_OTG_FS;
  HAL_GPIO_Init(GPIOA, &GPIO_InitStruct);

  /* Configure VBUS Pin */
  GPIO_InitStruct.Pin = GPIO_PIN_9;
  GPIO_InitStruct.Mode = GPIO_MODE_INPUT;
  GPIO_InitStruct.Pull = GPIO_NOPULL;
  HAL_GPIO_Init(GPIOA, &GPIO_InitStruct);

  /* ID Pin */
  GPIO_InitStruct.Pin = GPIO_PIN_10;
  GPIO_InitStruct.Mode = GPIO_MODE_AF_OD;
  GPIO_InitStruct.Pull = GPIO_PULLUP;
  GPIO_InitStruct.Speed = GPIO_SPEED_HIGH;
  GPIO_InitStruct.Alternate = GPIO_AF10_OTG_FS;
  HAL_GPIO_Init(GPIOA, &GPIO_InitStruct);

  // Enable USB OTG clock
  __HAL_RCC_USB_OTG_FS_CLK_ENABLE();
#else
  /* Configure USB HS GPIOs */
  __HAL_RCC_GPIOB_CLK_ENABLE();

  /* Configure USB D+ D- Pins */
  GPIO_InitStruct.Pin = GPIO_PIN_14 | GPIO_PIN_15;
  GPIO_InitStruct.Speed = GPIO_SPEED_HIGH;
  GPIO_InitStruct.Mode = GPIO_MODE_AF_PP;
  GPIO_InitStruct.Pull = GPIO_NOPULL;
  GPIO_InitStruct.Alternate = GPIO_AF12_OTG_HS_FS;
  HAL_GPIO_Init(GPIOB, &GPIO_InitStruct);

  /* Configure VBUS Pin */
  GPIO_InitStruct.Pin = GPIO_PIN_13;
  GPIO_InitStruct.Mode = GPIO_MODE_INPUT;
  GPIO_InitStruct.Pull = GPIO_NOPULL;
  HAL_GPIO_Init(GPIOB, &GPIO_InitStruct);

  /* ID Pin */
  GPIO_InitStruct.Pin = GPIO_PIN_12;
  GPIO_InitStruct.Mode = GPIO_MODE_AF_OD;
  GPIO_InitStruct.Pull = GPIO_PULLUP;
  GPIO_InitStruct.Speed = GPIO_SPEED_HIGH;
  GPIO_InitStruct.Alternate = GPIO_AF12_OTG_HS_FS;
  HAL_GPIO_Init(GPIOB, &GPIO_InitStruct);

  // Enable USB OTG clock
  __HAL_RCC_USB_OTG_HS_CLK_ENABLE();
#endif

#ifdef STM32F412Zx
  /* Configure POWER_SWITCH IO pin */
  __HAL_RCC_GPIOG_CLK_ENABLE();
  GPIO_InitStruct.Pin = GPIO_PIN_8;
  GPIO_InitStruct.Mode = GPIO_MODE_OUTPUT_OD;
  GPIO_InitStruct.Pull = GPIO_NOPULL;
  HAL_GPIO_Init(GPIOG, &GPIO_InitStruct);
#endif

  board_vbus_sense_init();
}

//--------------------------------------------------------------------+
// Board porting API
//--------------------------------------------------------------------+

void board_led_write(bool state) {
  GPIO_PinState pin_state = (GPIO_PinState) (state ? LED_STATE_ON : (1 - LED_STATE_ON));
  HAL_GPIO_WritePin(LED_PORT, LED_PIN, pin_state);
}

uint32_t board_button_read(void) {
  return BUTTON_STATE_ACTIVE == HAL_GPIO_ReadPin(BUTTON_PORT, BUTTON_PIN);
}

size_t board_get_unique_id(uint8_t id[], size_t max_len) {
  (void) max_len;
  volatile uint32_t *stm32_uuid = (volatile uint32_t *) UID_BASE;
  uint32_t *id32 = (uint32_t *) (uintptr_t) id;
  uint8_t const len = 12;

  id32[0] = stm32_uuid[0];
  id32[1] = stm32_uuid[1];
  id32[2] = stm32_uuid[2];

  return len;
}

int board_uart_read(uint8_t *buf, int len) {
  (void) buf;
  (void) len;
  return 0;
}

int board_uart_write(void const *buf, int len) {
#ifdef UART_DEV
  HAL_UART_Transmit(&UartHandle, (uint8_t *) (uintptr_t) buf, len, 0xffff);
  return len;
#else
  (void) buf; (void) len;
  return 0;
#endif
}

#if CFG_TUSB_OS == OPT_OS_NONE
volatile uint32_t system_ticks = 0;

void SysTick_Handler(void) {
  HAL_IncTick();
  system_ticks++;
}

uint32_t board_millis(void) {
  return system_ticks;
}

#endif

void HardFault_Handler(void) {
  __asm("BKPT #0\n");
}

// Required by __libc_init_array in startup code if we are compiling using
// -nostdlib/-nostartfiles.
//void _init(void) {
//}
