denisgav/stm32f401ccu6_uac2_headset/(commit log)

2024-10-20 Update button handling functions
2024-10-23 Optimization for microphone ring buffer
    Making interrupt handling function for microphone shorter
    [main.c, ring_buf.c, ring_buf.h]
2024-10-23 Mini fix for I2S error handling
    [main.c]
2024-10-23 Fixing microphone memory allocation
    [main.c, ring_buf.c, ring_buf.h]
2024-11-13 Fix compilation warnings
    Commenting EN_ROTARY_ENCODER disables rotary encoder in case if it works not stable.
    [main.c, ring_buf.c, ring_buf.h]
2024-11-17 Redesign a board
2024-11-17 Remove unused code
    The PCB is defined. Remove macro USB_HID_AUDIO_CTRL_ACTIVE and EN_ROTARY_ENCODER. Microphone is on mono mode, CFG_TUD_AUDIO_FUNC_1_N_CHANNELS_TX = 1.
2024-11-17 Fix microphone 16b format
    [main.c]
2024-11-19 First try to add 44.1 kHz sample rate
2024-11-19 Fix for microphone format 44.1 kHz
    [main.c]
2024-11-20 Print HID status on LCD
2024-11-21 Use DMA to update data on LCD
    Experimental feature.
